tedl57/bbtc/documentation/bbtc-relay-board.png

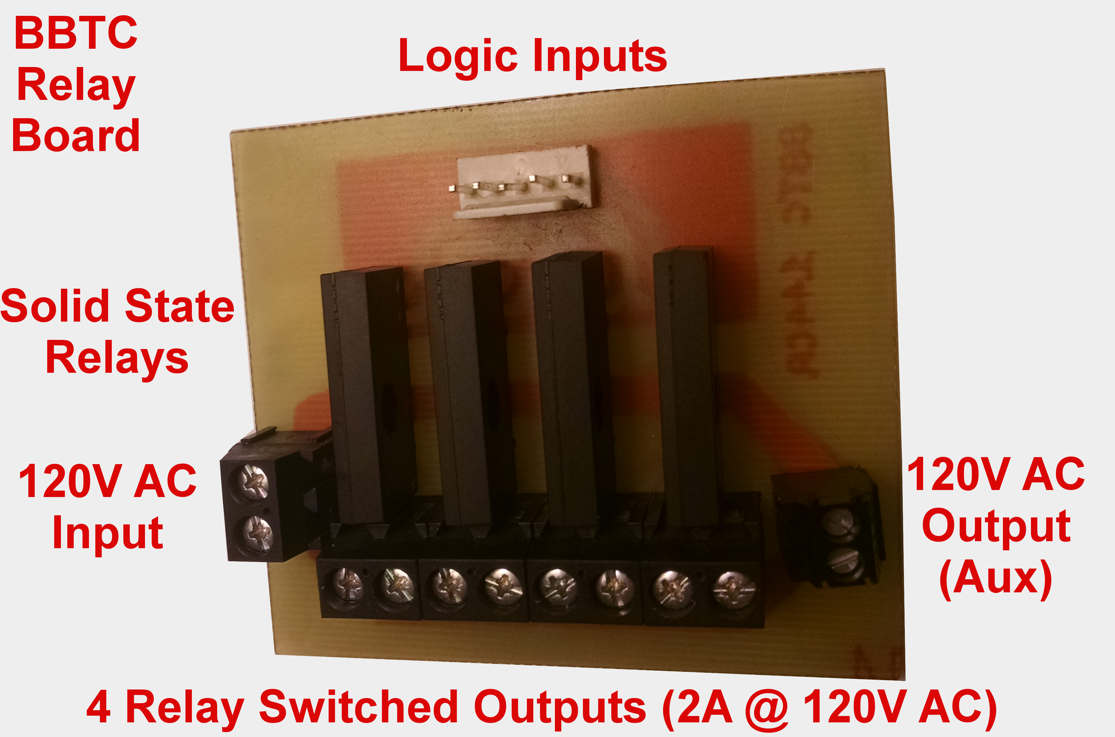
documentation/bbtc-relay-board.png
