tedl57/bbtc/documentation/bbtc-logic-board.png

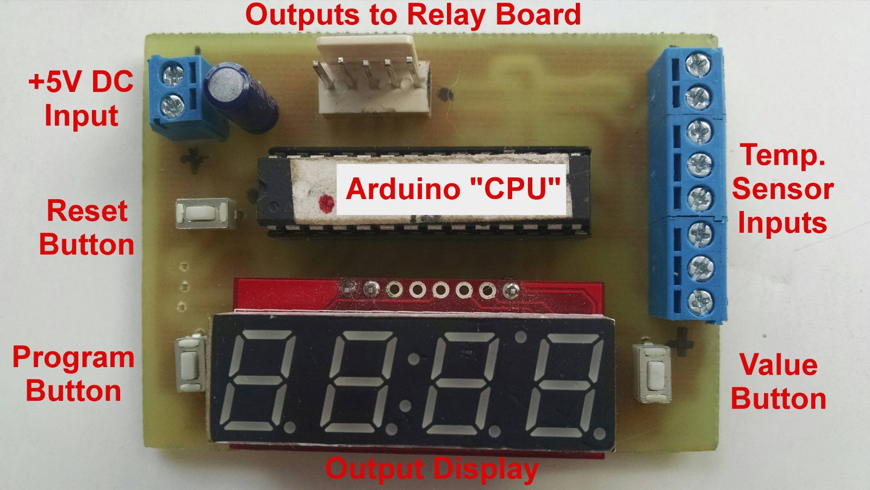
documentation/bbtc-logic-board.png
