tedl57/bbtc/README.md

# bbtc
Battery Box Temperature Controller

The BBTC is an Arduino-based circuit that independently measures and controls the temperatures of up to 4 battery boxes.
