tedl57/bbtc/hardware/README.md

# bbtc-hardware
Battery Box Temperature Controller Hardware

These are the Eagle (cadsoft) schematics and board layouts for the logic and relay boards.
