tedl57/bbtc/firmware/README.md

# bbtc-firmware
Battery Box Temperature Controller Firmware

This Arduino sketch implements the BBTC.
