tedl57/bbtc/documentation/bbtc-connections.png

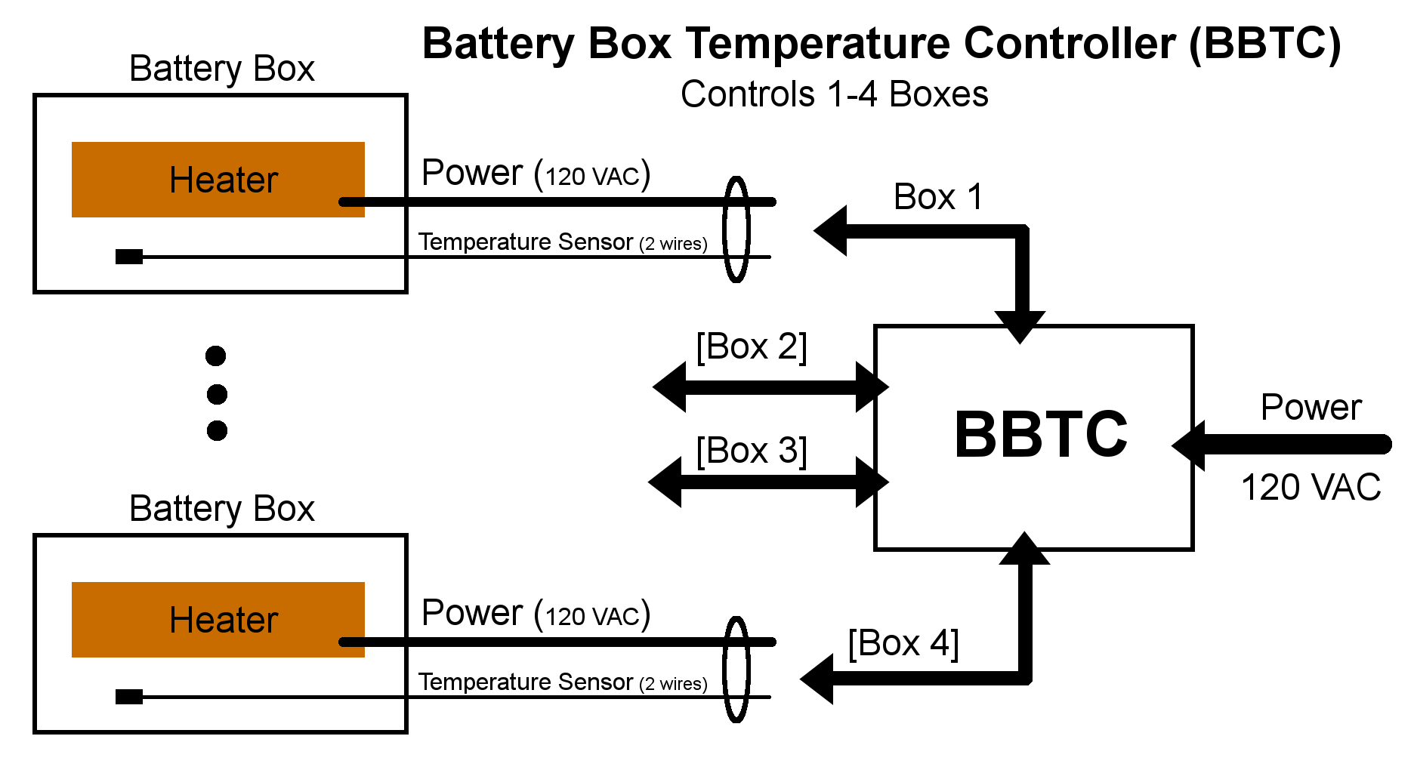
documentation/bbtc-connections.png
