tedl57/bbtc/hardware/bbtc-logic.brd

## EAGLE design hardware/bbtc-logic.brd (2015-06-03)

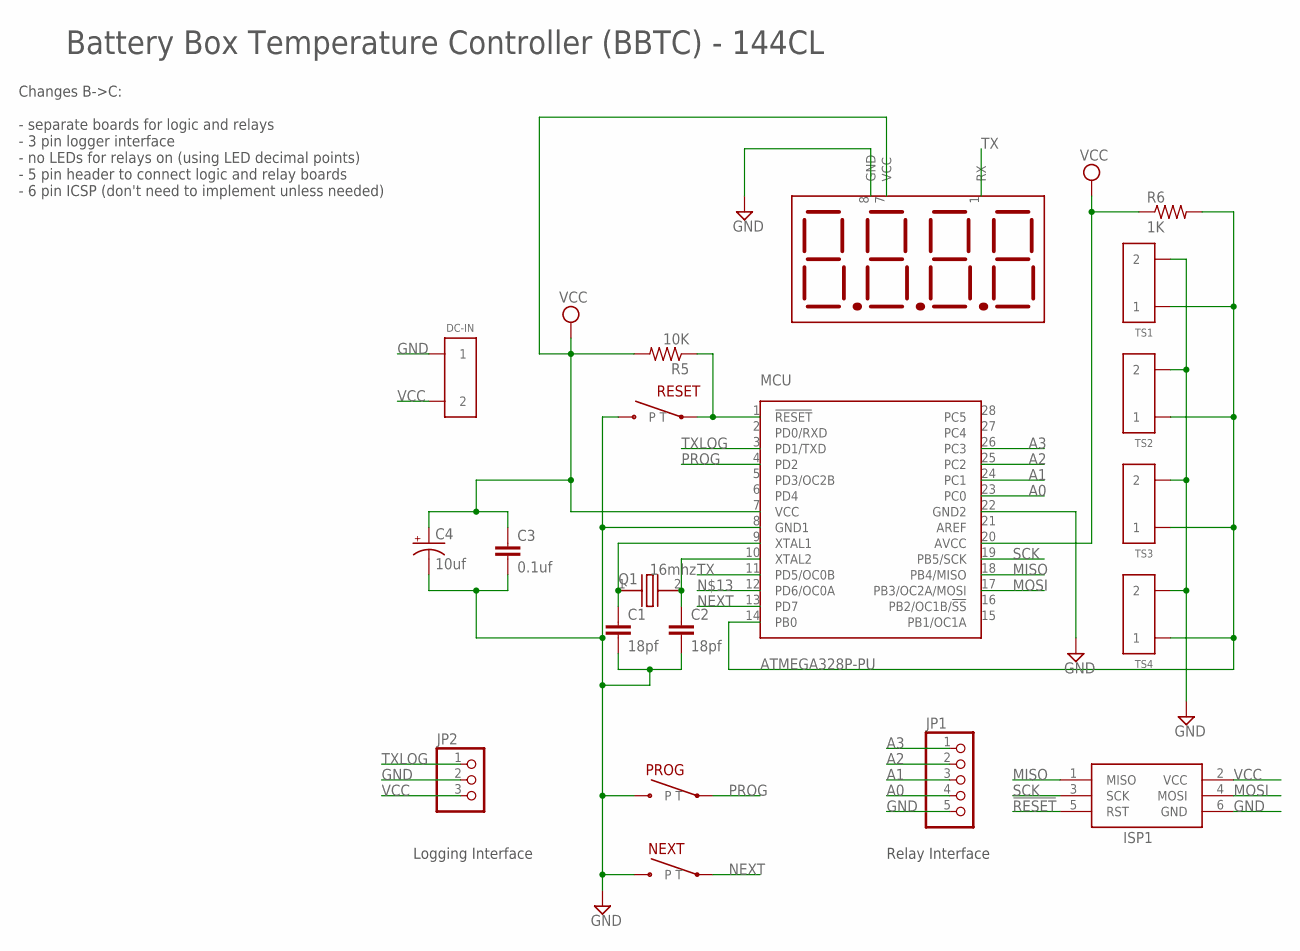
[picture p4: schematic bbtc-logic.sch]

Parts:
4-DIG-DISPLAY: 4-DIGIT-DISPLAY; 3SIL-OF-8
C1, C2: 18pf; C0805
C3: 0.1uf; C0805
C4: 10uf; E2-4
DC-IN: SCREW-CLAMP-1255; SCREW-CLAMP-ADAFRUIT-2X3.5MM
ISP1: AVRISP-6; AVRISP
JP1: PINHD-1X5; 1X05
JP2: PINHD-1X3; 1X03
MCU: ATMEGA328P-PU; DIL28-3
NEXT: SWITCH-SPST-NEW; SWITCH-ADAFRUIT-6MM-SLIM
PROG: SWITCH-SPST-NEW; SWITCH-ADAFRUIT-6MM-SLIM
Q1: 16mhz; CRYSTAL-5X3.2MM-1024
R5: 10K; R0805
R6: 1K; M0805
RESET: SWITCH-SPST-NEW; SWITCH-ADAFRUIT-6MM-SLIM
TS1, TS2, TS3, TS4: SCREW-CLAMP-1255; SCREW-CLAMP-ADAFRUIT-2X3.5MM

Connections:
1W: MCU.14 (PB0), R6.2, TS1.1, TS2.1, TS3.1, TS4.1
!RESET: ISP1.5 (RST), MCU.1 (!RESET), R5.1, RESET.T
A0: JP1.4, MCU.23 (PC0)
A1: JP1.3, MCU.24 (PC1)
A2: JP1.2, MCU.25 (PC2)
A3: JP1.1, MCU.26 (PC3)
GND: 4-DIG-DISPLAY.8 (GND), C1.2, C2.2, C3.2, C4.-, DC-IN.1, ISP1.6 (GND), JP1.5, JP2.2, MCU.8 (GND1), MCU.22 (GND2), NEXT.P, PROG.P, RESET.P, TS1.2, TS2.2, TS3.2, TS4.2
MISO: ISP1.1 (MISO), MCU.18 (PB4/MISO)
MOSI: ISP1.4 (MOSI), MCU.17 (PB3/OC2A/MOSI)
unnamed: C1.1, MCU.9 (XTAL1), Q1.1
unnamed: C2.1, MCU.10 (XTAL2), Q1.2
NEXT: MCU.13 (PD7), NEXT.T
PROG: MCU.4 (PD2), PROG.T
SCK: ISP1.3 (SCK), MCU.19 (PB5/SCK)
TX: 4-DIG-DISPLAY.1 (RX), MCU.11 (PD5/OC0B)
TXLOG: JP2.1, MCU.3 (PD1/TXD)
VCC: 4-DIG-DISPLAY.7 (VCC), C3.1, C4.+, DC-IN.2, ISP1.2 (VCC), JP2.3, MCU.7 (VCC), MCU.20 (AVCC), R5.2, R6.1

Notes on the sheet:
Battery Box Temperature Controller (BBTC) - 144CL
Changes B->C: - separate boards for logic and relays - 3 pin logger interface - no LEDs for relays on (using LED decimal points) - 5 pin header to connect logic and relay boards - 6 pin ICSP (don't need to implement unless needed)
Relay Interface
Logging Interface

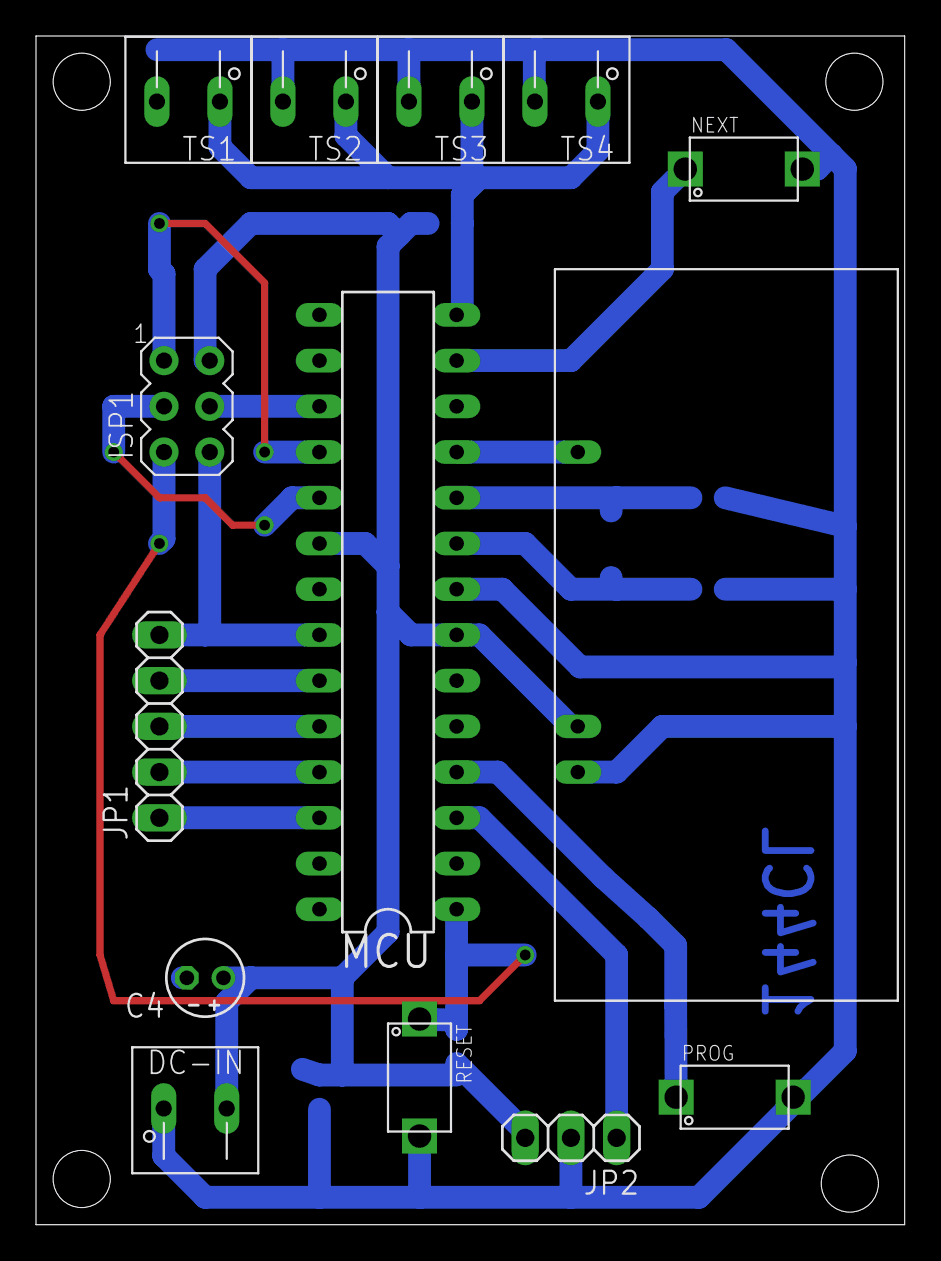
[picture p5: board bbtc-logic.brd from above]

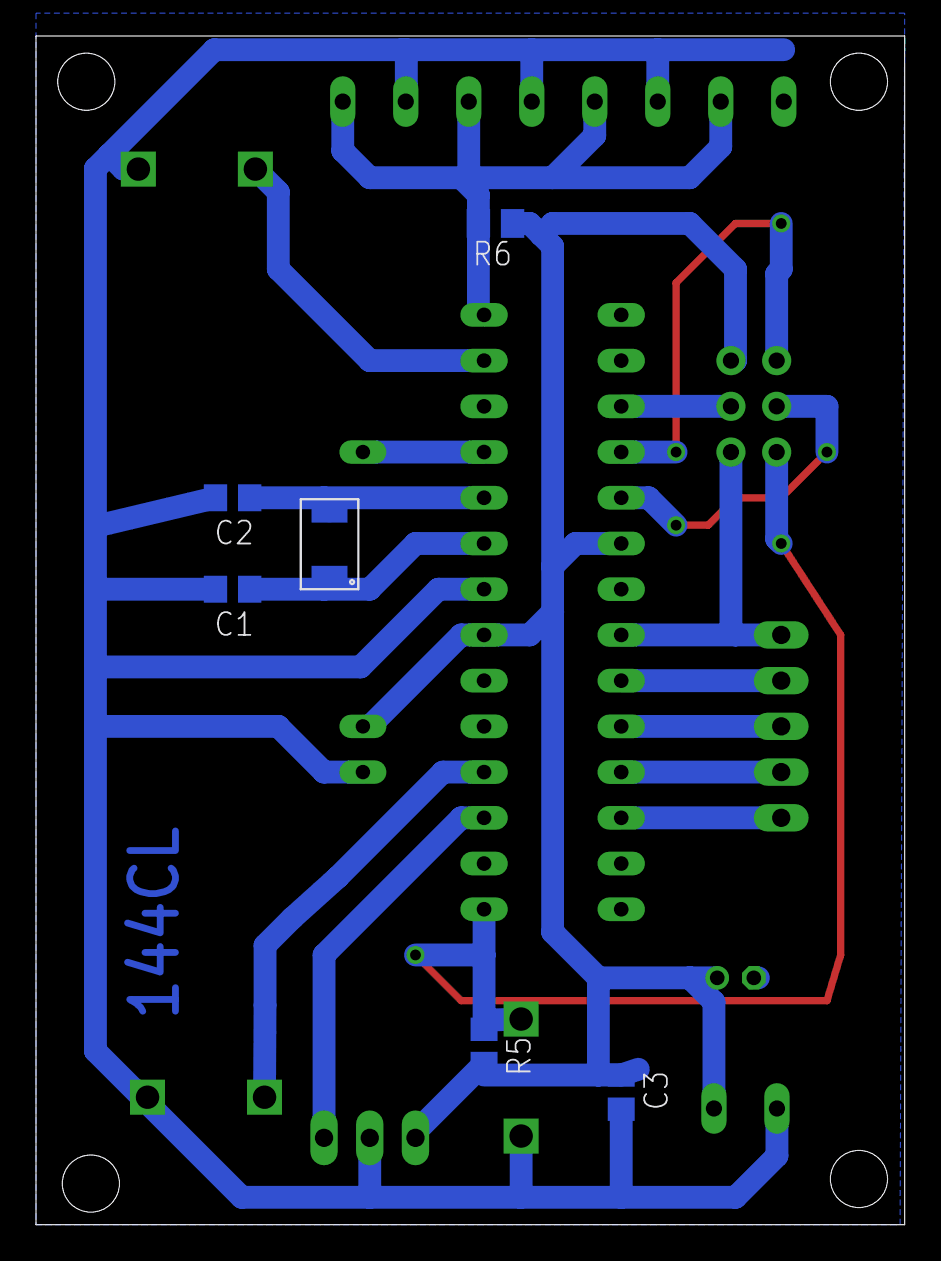
[picture p6: board bbtc-logic.brd from below]

Board: 2 copper layers, 48.3 x 66.0 mm, 20 parts (6 on the bottom side), 17 nets.
