tedl57/bbtc/hardware/bbtc-relays.brd

## EAGLE design hardware/bbtc-relays.brd (2015-06-03)

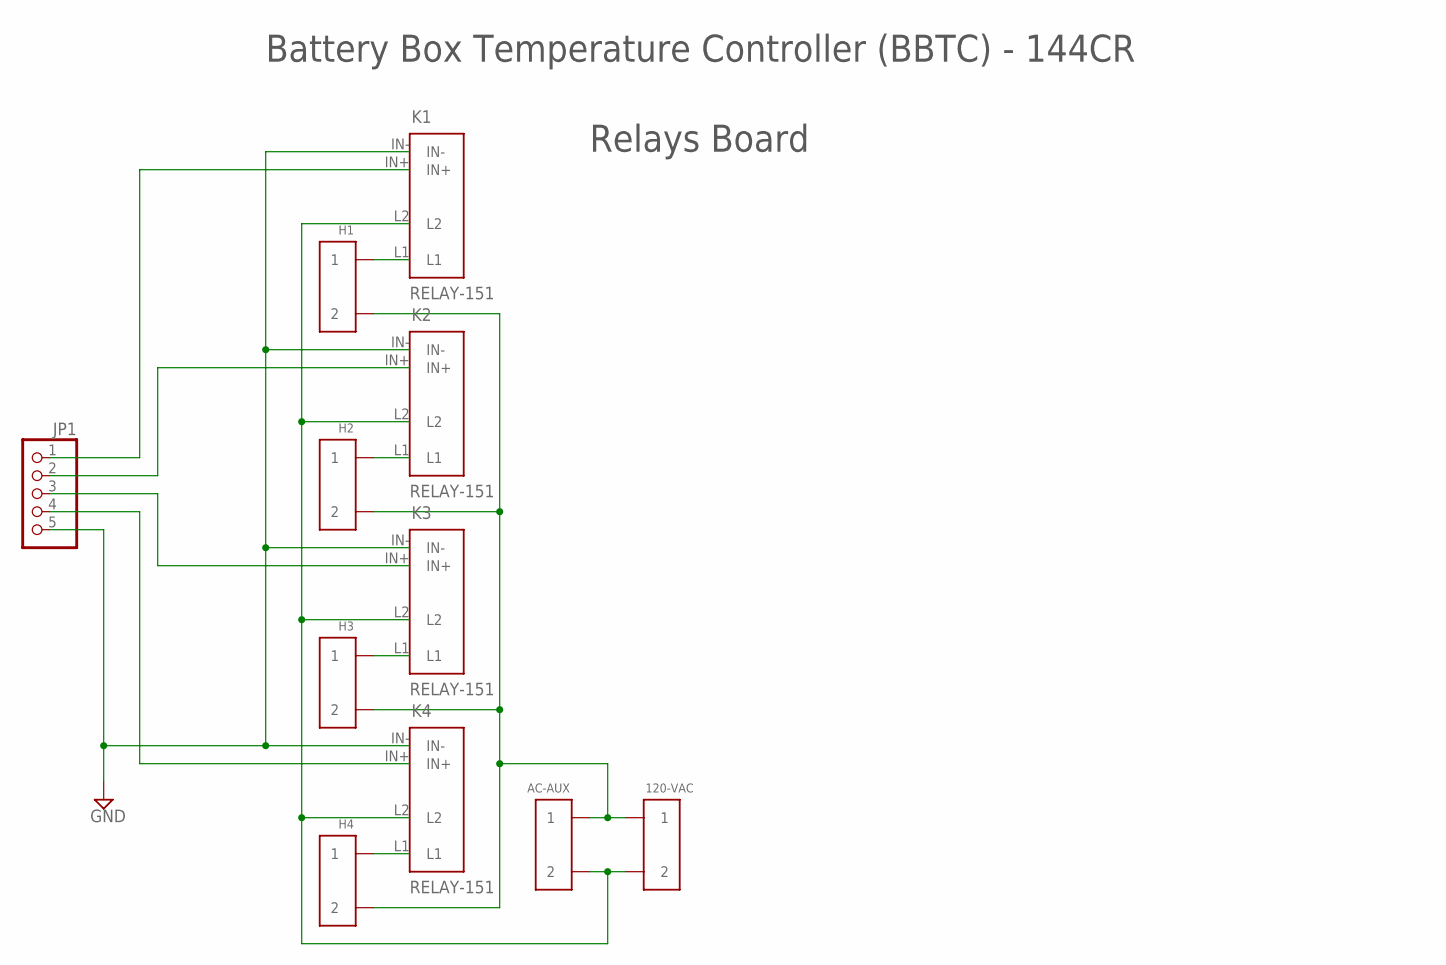
[picture p7: schematic bbtc-relays.sch]

Parts:
120-VAC: SCREW-CLAMP-906
AC-AUX: SCREW-CLAMP-909
H1, H2, H3, H4: SCREW-CLAMP-906
JP1: PINHD-1X5; 1X05
K1, K2, K3, K4: RELAY-151

Connections:
GND: JP1.5, K1.IN-, K2.IN-, K3.IN-, K4.IN-
L1: 120-VAC.1, AC-AUX.1, H1.2, H2.2, H3.2, H4.2
L2: 120-VAC.2, AC-AUX.2, K1.L2, K2.L2, K3.L2, K4.L2
unnamed: H4.1, K4.L1
unnamed: H3.1, K3.L1
unnamed: JP1.1, K1.IN+
unnamed: H2.1, K2.L1
unnamed: H1.1, K1.L1
unnamed: JP1.2, K2.IN+
unnamed: JP1.3, K3.IN+
unnamed: JP1.4, K4.IN+

Notes on the sheet:
Battery Box Temperature Controller (BBTC) - 144CR
Relays Board

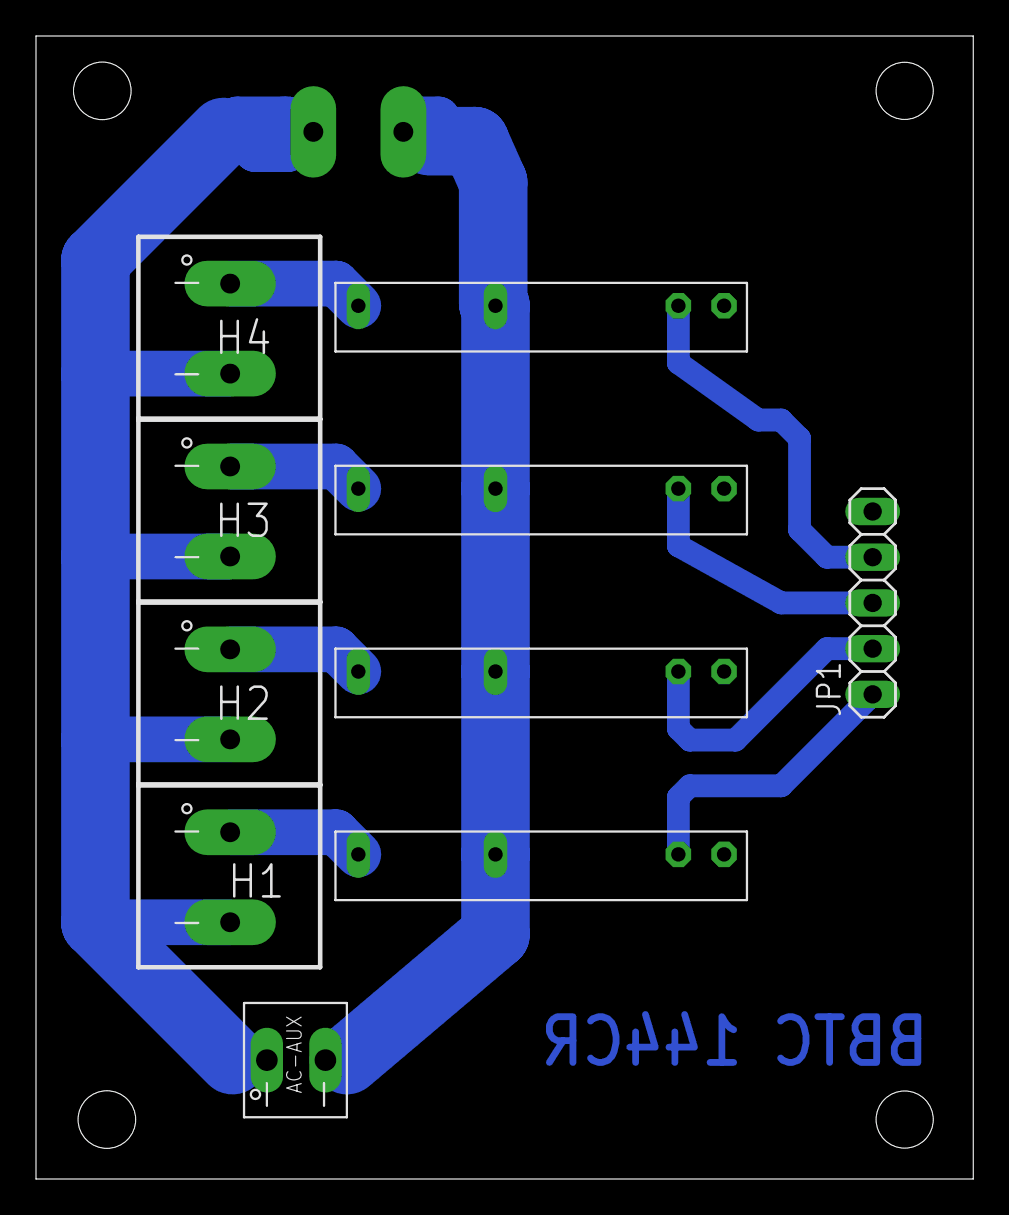
[picture p8: board bbtc-relays.brd from above]

Board: 2 copper layers, 52.1 x 63.5 mm, 11 parts (1 on the bottom side), 11 nets.
